gauravmm/TurboCAN/hardware/turbocan.kicad_pcb

## KiCad design hardware/turbocan.kicad_pcb (2022-03-23)

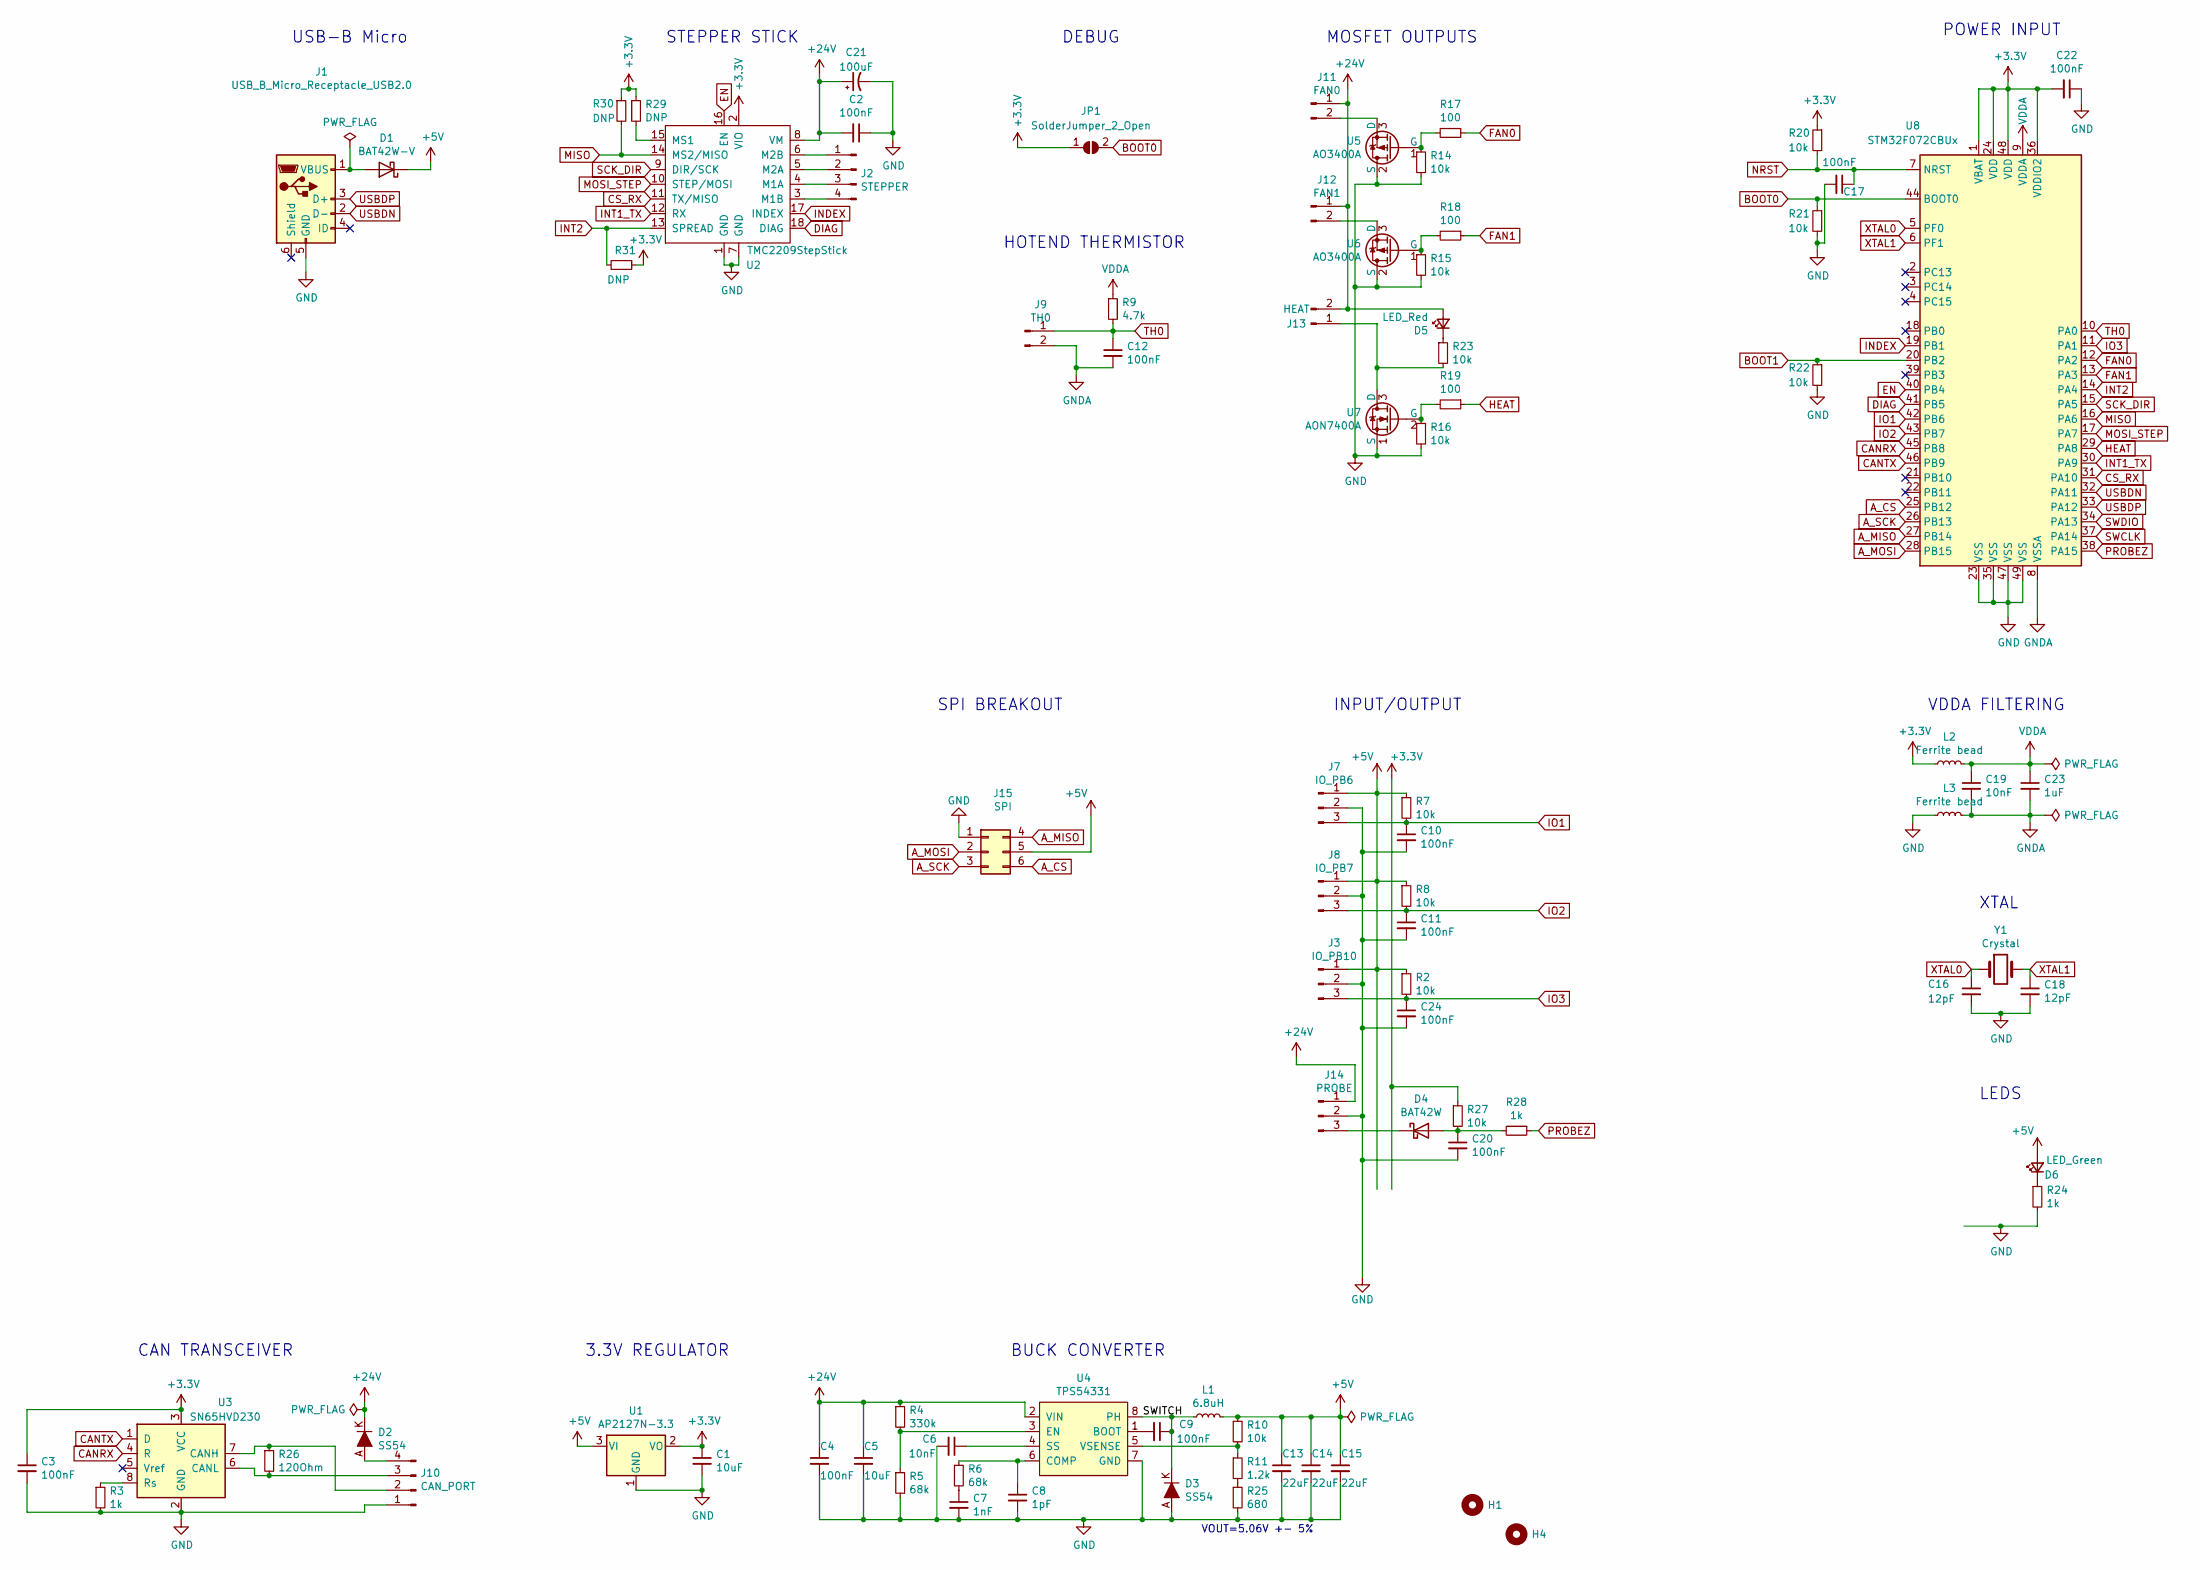
[picture p1: schematic turbocan.kicad_sch]

Parts:
C1, C5: 10uF; C_0805_2012Metric; LCSC Part Number C15850
C2, C3, C4, C9, C10, C11, C12, C17, C20, C22, C24: 100nF; C_0402_1005Metric; LCSC Part Number C1525
C6, C19: 10nF; C_0402_1005Metric; LCSC Part Number C15195
C7: 1nF; C_0402_1005Metric; LCSC Part Number C1523
C8: 1pF; C_0402_1005Metric; LCSC Part Number C1550
C13, C14, C15: 22uF; C_0805_2012Metric; LCSC Part Number C45783
C16, C18: 12pF; C_0402_1005Metric; LCSC Part Number C1547
C21: 100uF; CP_Elec_8x10; LCSC Part Number C59944
C23: 1uF; C_0402_1005Metric; LCSC Part Number C52923
D1: BAT42W-V; D_SOD-123; LCSC Part Number C8598
D2, D3: SS54; DO-214AC; MPN SS14; Digi-Key_PN SS14CT-ND
D4: BAT42W; D_SOD-123; LCSC Part Number C8598
D5: LED_Red; LED_0603_1608Metric; LCSC Part Number C2286
D6: LED_Green; LED_0603_1608Metric; LCSC Part Number C72043
H1, H4: MountingHole; MountingHole_3.2mm_M3_DIN965_Pad
J1: USB_B_Micro_Receptacle_USB2.0; USB_Micro-B_Amphenol_10118194_Horizontal
J2: STEPPER; JST_XH_B4B-XH-A_1x04_P2.50mm_Vertical
J3: IO_PB10; JST_XH_B3B-XH-A_1x03_P2.50mm_Vertical
J7: IO_PB6; JST_XH_B3B-XH-A_1x03_P2.50mm_Vertical
J8: IO_PB7; JST_XH_B3B-XH-A_1x03_P2.50mm_Vertical
J9: TH0; JST_XH_B2B-XH-A_1x02_P2.50mm_Vertical
J10: CAN_PORT; JST_XH_B4B-XH-A_1x04_P2.50mm_Vertical
J11: FAN0; JST_XH_B2B-XH-A_1x02_P2.50mm_Vertical
J12: FAN1; JST_XH_B2B-XH-A_1x02_P2.50mm_Vertical
J13: HEAT; JST_XH_B2B-XH-A_1x02_P2.50mm_Vertical
J14: PROBE; JST_XH_B3B-XH-A_1x03_P2.50mm_Vertical
J15: SPI; PinHeader_2x03_P2.54mm_Vertical
JP1: SolderJumper_2_Open; SolderJumper-2_P1.3mm_Open_TrianglePad1.0x1.5mm
L1: 6.8uH; L_SMD_7.3x6.8; LCSC Part Number C207841
L2: Ferrite bead; L_0805_2012Metric; LCSC Part Number C1017
L3: Ferrite bead; L_0805_2012Metric
R2, R7, R8, R10, R14, R15, R16, R20, R21, R22, R27: 10k; R_0402_1005Metric; LCSC Part Number C25744
R3, R24, R28: 1k; R_0402_1005Metric; LCSC Part Number C11702
R4: 330k; R_0402_1005Metric; LCSC Part Number C25778
R5, R6: 68k; R_0402_1005Metric; LCSC Part Number C36871
R9: 4.7k; R_0805_2012Metric; LCSC Part Number C17673
R11: 1.2k; R_0402_1005Metric; LCSC Part Number C25862
R17, R18, R19: 100; R_0402_1005Metric; LCSC Part Number C25076
R23: 10k; R_0402_1005Metric; LCSC Part Number C11702
R25: 680; R_0402_1005Metric; LCSC Part Number C25130
R26: 120Ohm; R_0805_2012Metric; LCSC Part Number C17437
R29, R30, R31: DNP; R_0402_1005Metric
U1: AP2127N-3.3; SOT-23; LCSC Part Number C5446
U2: TMC2209StepStick
U3: SN65HVD230; SOIC-8_3.9x4.9mm_P1.27mm; LCSC Part Number C12084
U4: TPS54331; SOIC-8_3.9x4.9mm_P1.27mm; LCSC Part Number C9865
U5, U6: AO3400A; SOT-23; LCSC Part Number C344010
U7: AON7400A; DFN-8-1EP_3x3mm_P0.65mm_EP1.7x2.05mm_Thermal_Pad; LCSC C85734
U8: STM32F072CBUx; QFN-48-1EP_7x7mm_P0.5mm_EP5.6x5.6mm; LCSC Part Number C92504
Y1: Crystal; Crystal_SMD_5032-2Pin_5.0x3.2mm; LCSC Part Number C115962

Connections:
+3V3: C1.1, C3.1, C22.2, JP1.1 (A), L2.1, R20.1, R27.1, R29.1, R30.1, R31.1, U1.2 (VO), U2.2 (VIO), U3.3 (VCC), U8.1 (VBAT), U8.24 (VDD), U8.36 (VDDIO2), U8.48 (VDD)
+5V: C13.1, C14.1, C15.1, D1.1 (K), D6.2 (A), J3.1, J7.1, J8.1, J15.5, L1.2, R2.1, R7.1, R8.1, R10.1, U1.3 (VI)
+24V: C2.2, C4.1, C5.1, C21.1, D2.K, D5.2 (A), J11.1, J12.1, J13.2, J14.1, R4.1, U2.8 (VM), U4.2 (VIN)
/SWITCH: C9.1, D3.K, L1.1, U4.8 (PH)
A_CS: J15.6, U8.25 (PB12)
A_MISO: J15.4, U8.27 (PB14)
A_MOSI: J15.2, U8.28 (PB15)
A_SCK: J15.3, U8.26 (PB13)
BOOT0: JP1.2 (B), R21.1, U8.44 (BOOT0)
BOOT1: R22.1, U8.20 (PB2)
CANRX: U3.4 (R), U8.45 (PB8)
CANTX: U3.1 (D), U8.46 (PB9)
CS_RX: U2.11 (TX/MISO), U8.31 (PA10)
DIAG: U2.18 (DIAG), U8.41 (PB5)
EN: U2.16 (EN), U8.40 (PB4)
FAN0: R17.1, U8.12 (PA2)
FAN1: R18.1, U8.13 (PA3)
GND: C1.2, C2.1, C3.2, C4.2, C5.2, C6.2, C7.2, C8.2, C10.2, C11.2, C13.2, C14.2, C15.2, C16.2, C17.2, C18.2, C20.2, C21.2, C22.1, C24.2, D3.A, J1.5 (GND), J3.2, J7.2, J8.2, J10.1, J14.2, J15.1, L3.1, R3.2, R5.2, R14.2, R15.2, R16.2, R21.2, R22.2, R24.2, R25.2, U1.1 (GND), U2.1 (GND), U2.7 (GND), U3.2 (GND), U4.7 (GND), U5.2 (S), U6.2 (S), U7.1 (S), U8.23 (VSS), U8.35 (VSS), U8.47 (VSS), U8.49 (VSS)
GNDA: C12.2, C19.2, C23.2, J9.2, L3.2, U8.8 (VSSA)
HEAT: R19.1, U8.29 (PA8)
INDEX: U2.17 (INDEX), U8.19 (PB1)
INT1_TX: U2.12 (RX), U8.30 (PA9)
INT2: R31.2, U2.13 (SPREAD), U8.14 (PA4)
IO1: C10.1, J7.3, R7.2, U8.42 (PB6)
IO2: C11.1, J8.3, R8.2, U8.43 (PB7)
IO3: C24.1, J3.3, R2.2, U8.11 (PA1)
MISO: R30.2, U2.14 (MS2/MISO), U8.16 (PA6)
MOSI_STEP: U2.10 (STEP/MOSI), U8.17 (PA7)
NRST: C17.1, R20.2, U8.7 (NRST)
unnamed: C6.1, U4.4 (SS)
unnamed: C7.1, R6.2
unnamed: C8.1, R6.1, U4.6 (COMP)
unnamed: C9.2, U4.1 (BOOT)
unnamed: C20.1, D4.2 (A), R27.2, R28.2
unnamed: D1.2 (A), J1.1 (VBUS)
unnamed: D2.A, J10.4
unnamed: D4.1 (K), J14.3
unnamed: D6.1 (K), R24.1
unnamed: J2.1, U2.6 (M2B)
unnamed: J2.2, U2.5 (M2A)
unnamed: J2.3, U2.4 (M1A)
unnamed: J2.4, U2.3 (M1B)
unnamed: J10.2, R26.1, U3.7 (CANH)
unnamed: J10.3, R26.2, U3.6 (CANL)
unnamed: J11.2, U5.3 (D)
unnamed: J12.2, U6.3 (D)
unnamed: R3.1, U3.8 (Rs)
unnamed: R4.2, R5.1, U4.3 (EN)
unnamed: R10.2, R11.1, U4.5 (VSENSE)
unnamed: R11.2, R25.1
unnamed: R14.1, R17.2, U5.1 (G)
unnamed: R15.1, R18.2, U6.1 (G)
unnamed: R16.1, R19.2, U7.2 (G)
unnamed: D5.1 (K), R23.1
unnamed: R29.2, U2.15 (MS1)
unnamed: J13.1, R23.2, U7.3 (D)
PROBEZ: R28.1, U8.38 (PA15)
SCK_DIR: U2.9 (DIR/SCK), U8.15 (PA5)
SWCLK: U8.37 (PA14)
SWDIO: U8.34 (PA13)
TH0: C12.1, J9.1, R9.2, U8.10 (PA0)
USBDN: J1.2 (D-), U8.32 (PA11)
USBDP: J1.3 (D+), U8.33 (PA12)
VDDA: C19.1, C23.1, L2.2, R9.1, U8.9 (VDDA)
XTAL0: C16.1, U8.5 (PF0), Y1.1
XTAL1: C18.1, U8.6 (PF1), Y1.2

Notes on the sheet:
VDDA FILTERING
LEDS
HOTEND THERMISTOR
CAN TRANSCEIVER
STEPPER STICK
BUCK CONVERTER
MOSFET OUTPUTS
INPUT/OUTPUT
VOUT=5.06V +- 5%
3.3V REGULATOR
XTAL
SPI BREAKOUT
USB-B Micro
DEBUG
POWER INPUT

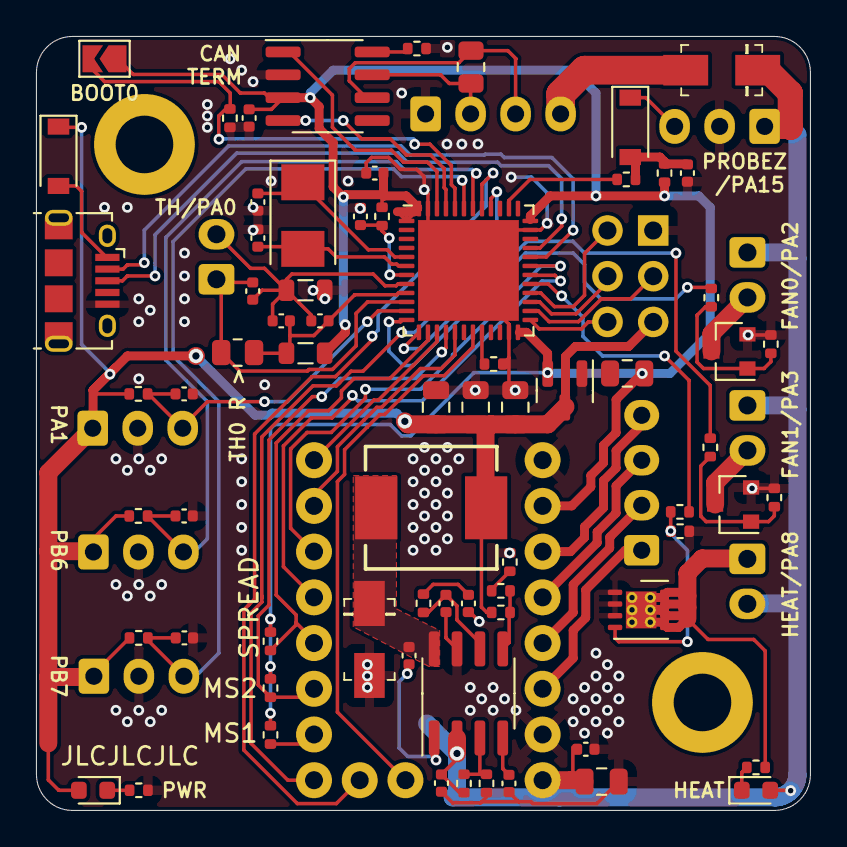
[picture p2: board turbocan.kicad_pcb from above]

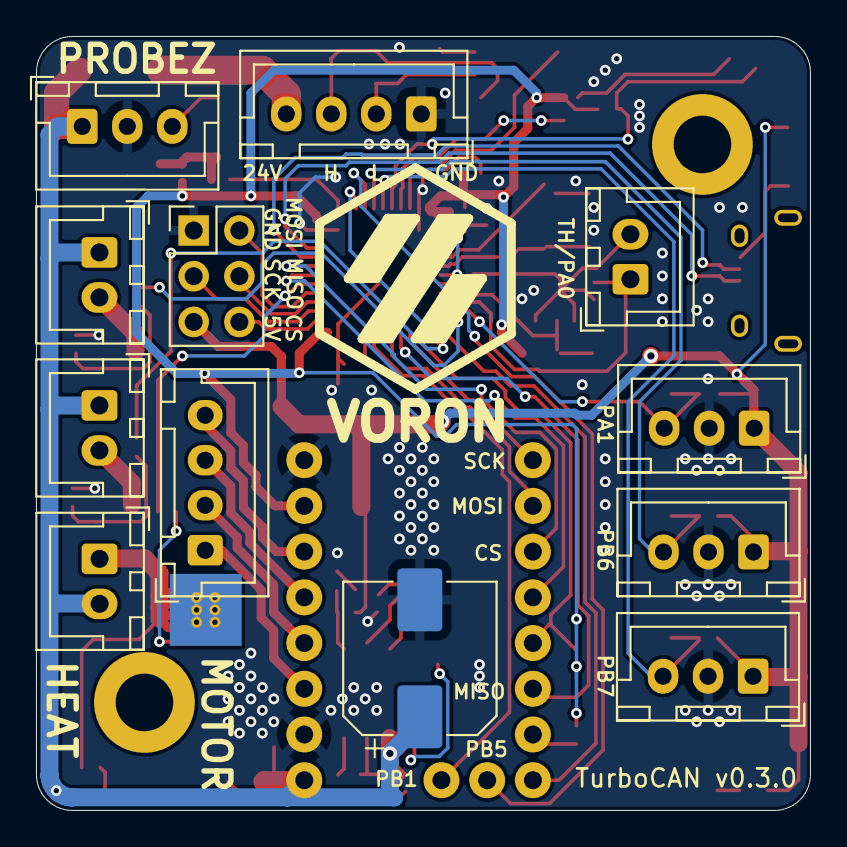
[picture p3: board turbocan.kicad_pcb from below]

Board: 2 copper layers, 43.0 x 43.0 mm, 85 parts (13 on the bottom side), 64 nets.
