gauravmm/TurboCAN/(threads)

Thread 1 (2022-03-20):

Power Filtering for MCU

gauravmm, 2022-03-20:
VDDIO2 and VDD need to be separately filtered (to prevent ripples from the IO influencing the main power supply.)

See Section 6.1.6/Page 49 in [the datasheet](https://www.mouser.com/datasheet/2/389/dm00090510-1797802.pdf).
