gauravmm/TurboCAN/(commit log)

2022-03-18 Upgraded to KiCAD 6
    [turbocan.kicad_pcb, turbocan.kicad_sch, turbocan.sch]
2022-03-21 Updated schematic with generic IO, removed ADXL.
    [turbocan.kicad_sch]
2022-03-21 First Test
    [turbocan.kicad_pcb, turbocan.kicad_sch]
2022-03-22 Before DRC
    [turbocan.kicad_pcb, turbocan.kicad_sch]
2022-03-22 Fixed violations, still have more DRC.
    [turbocan.kicad_pcb]
2022-03-23 First Manufacturing Upload
    [turbocan.kicad_pcb, turbocan.kicad_sch]
2022-03-23 Updated manufacturer files for 0.3.0 first draft.
    [turbocan-B_Cu.gbr, turbocan-B_Mask.gbr, turbocan-B_Paste.gbr, turbocan-B_SilkS.gbr, turbocan-B_Silkscreen.gbr, turbocan-Edge_Cuts.gbr, turbocan-F_Cu.gbr, turbocan-F_Mask.gbr]
2022-03-23 Change headers to be compatible with JLCPCB
    [turbocan-top-pos-jlcpcb.csv]
2022-03-23 First manufacturing draft.
    [turbocan_bom.csv]
